fille044/WS2.0/Dokument/Inkopslista.txt

Jordfuktsmätare för Arduino
79:90:-
https://www.kjell.com/se/sortiment/el-verktyg/elektronik/arduino/moduler/jordfuktsmatare-for-arduino-p87941

Ställbar nätadapter 3-12 V (DC) 3,6 W
99:90:-
https://www.kjell.com/se/sortiment/el-verktyg/stromforsorjning/nataggregat/ac-dc/stallbar-utspanning/stallbar-natadapter-3-12-v-(dc)-3-6-w-p44108

2x Arkadknapp 33 mm Blå
99:80:-
https://www.kjell.com/se/sortiment/el-verktyg/elektronik/arduino/tillbehor/arkadknapp-33-mm-bla-p36196

Realtidsklocka för Arduino
79:90
https://www.kjell.com/se/sortiment/el-verktyg/elektronik/arduino/moduler/realtidsklocka-for-arduino-p87984
