fille044/WS2.0/Dokument/init.png

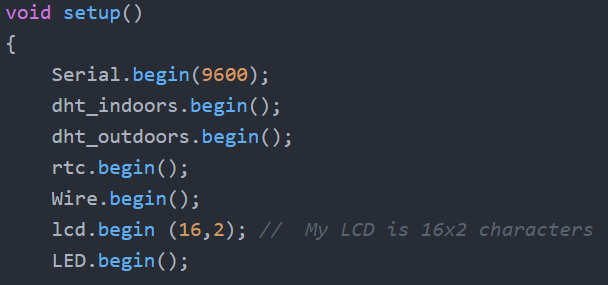
Dokument/init.png
