fille044/WS2.0/Dokument/navigation.png

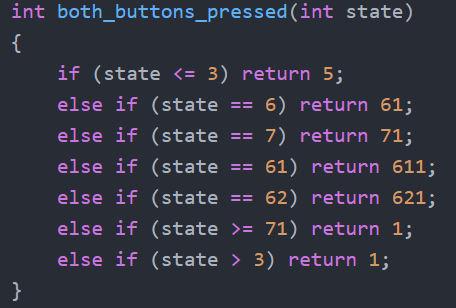
Dokument/navigation.png
