fille044/WS2.0/Inlämning Filip Lindström/KRETSSCHEMA_schem.png

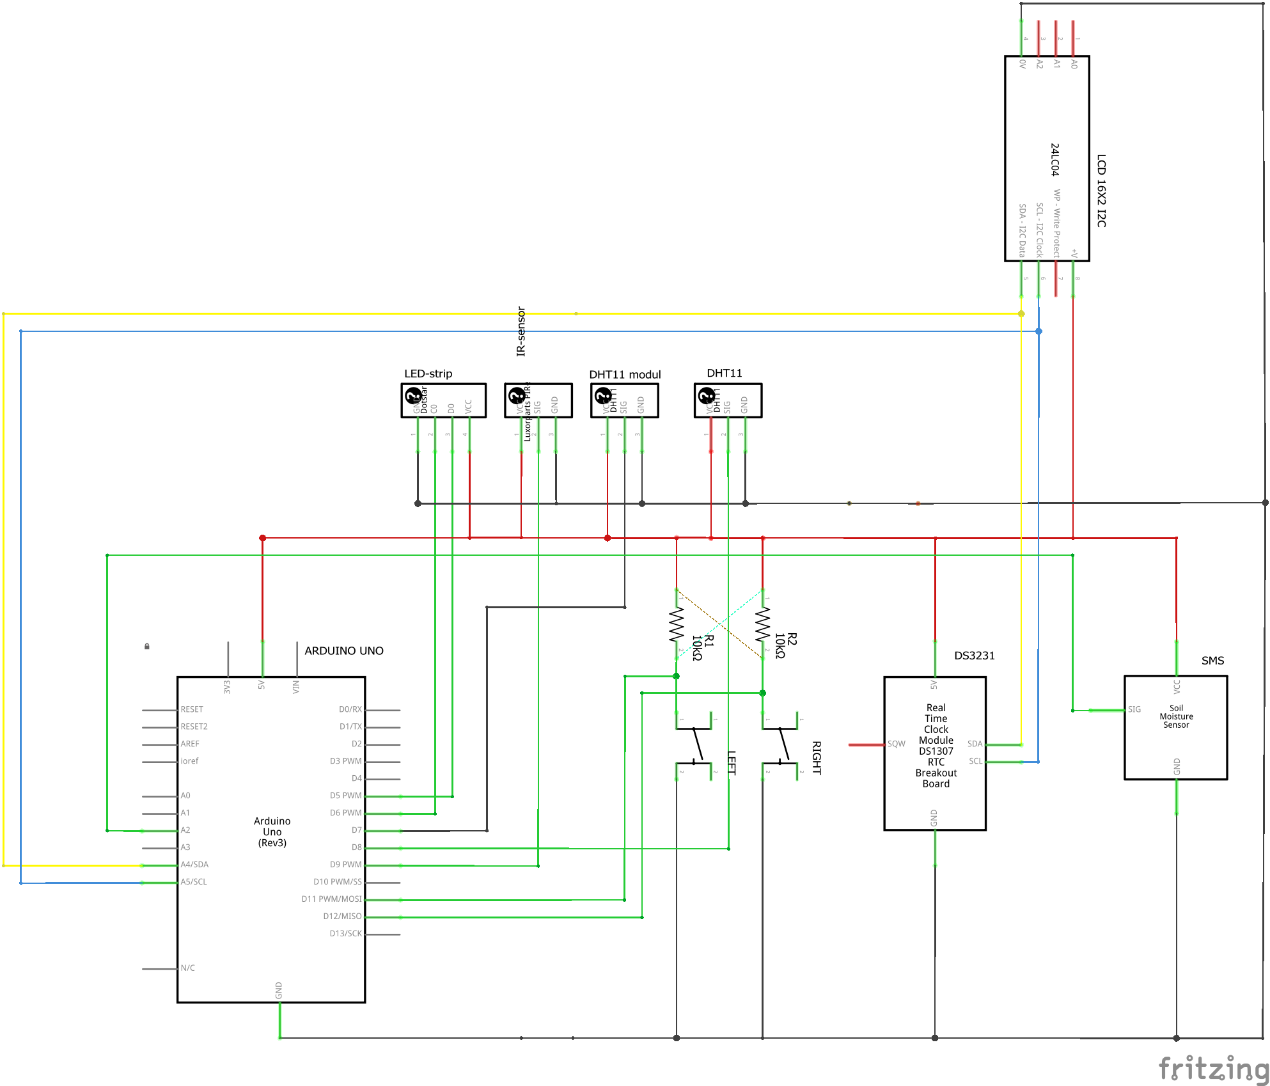
Inlämning Filip Lindström/KRETSSCHEMA_schem.png
