fille044/WS2.0/(list of files, drawings)

Other design files:
Dokument/KRETSSCHEMA.fzz
