fille044/WS2.0/(commit log)

2017-03-16 Started Atmel-project, and arduino project
2017-03-16 Progress on arduino IDE
    All sensors mounted and working, including the rtc
    LCD screen is fighting against
2017-03-17 LCD working, button mounted, start of navigation and modularizing
2017-04-18 Much has happened since last push
    [KRETSSCHEMA.fzz]
